illdefined/phq-u/phq-u.kicad_pcb

## KiCad design phq-u.kicad_pcb (2022-02-26)

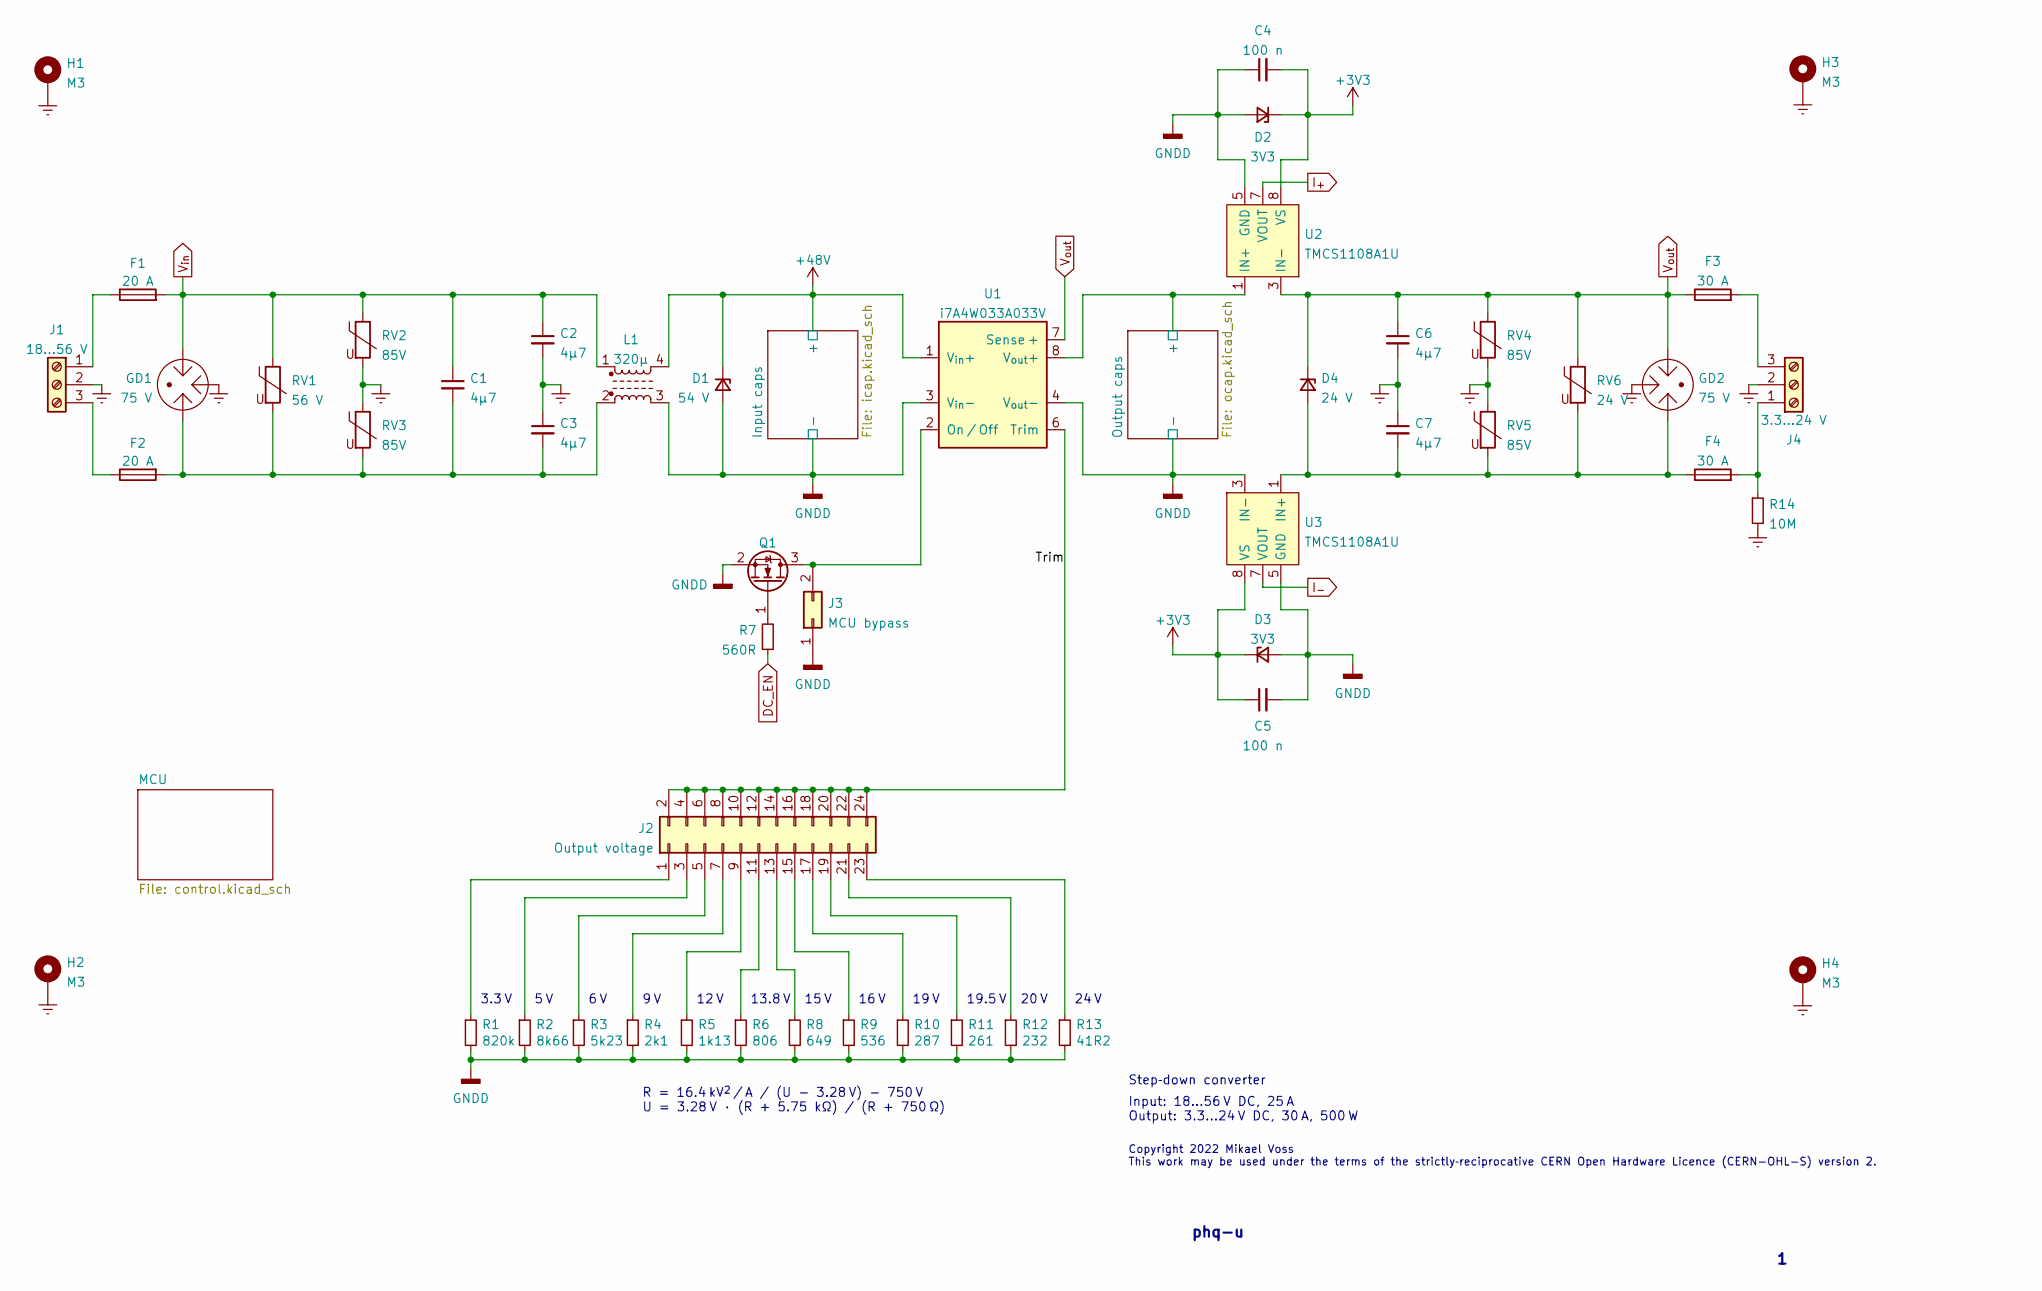
[picture p1: schematic phq-u.kicad_sch]

Parts:
C1, C2, C3, C6, C7: 4µ7; C_1210_3225Metric; Part Number 12101C475K4T2A
C4, C5: 100 n; C_0402_1005Metric
D1: 54 V; D_SMB; Part Number 1.5SMBJ54A-H
D2, D3: 3V3; D_0402_1005Metric; Part Number DF2S5M4CT
D4: 24 V; D_SMA; Part Number SMA6F24A
F1, F2: 20 A; Fuse_2410_20A; Part Number CB61F30A
F3, F4: 30 A; Fuse_2410_20A; Part Number CB61F30A
GD1, GD2: 75 V; 2036-NN-SM; Part Number 2036-07-SM
H1, H2, H3, H4: M3; MountingHole_3.2mm_M3_Pad_Via
J1: 18…56 V; Phoenix_1987737
J2: Output voltage; PinHeader_2x12_P2.00mm_Vertical
J3: MCU bypass; PinHeader_2x01_P2.00mm_Vertical
J4: 3.3…24 V; Phoenix_1987737
L1: 320µ; CMX1211Z321B-10
Q1: NX138AKR; SOT-23; Part Number NX138AKR
R1: 820k; R_0603_1608Metric
R2: 8k66; R_0603_1608Metric
R3: 5k23; R_0603_1608Metric
R4: 2k1; R_0603_1608Metric
R5: 1k13; R_0603_1608Metric
R6: 806; R_0603_1608Metric
R7: 560R; R_0402_1005Metric
R8: 649; R_0603_1608Metric
R9: 536; R_0603_1608Metric
R10: 287; R_0603_1608Metric
R11: 261; R_0603_1608Metric
R12: 232; R_0603_1608Metric
R13: 41R2; R_0603_1608Metric
R14: 10M; R_0603_1608Metric
RV1: 56 V; C_2220_5650Metric; Part Number B72540E0400K062
RV2, RV3, RV4, RV5: 85V; C_1206_3216Metric; Part Number ZV60K1206121NIR1
RV6: 24 V; C_1210_3225Metric; Part Number B72530T6170K062
U1: i7A4W033A033V; i7A4W-0C1; Part Number i7A4W033A033V-0C1
U2, U3: TMCS1108A1U; SOIC-8_3.9x4.9mm_P1.27mm

Connections:
+3V3: C4.2, C5.1, D2.1 (K), D3.1 (K), U2.8 (VS), U3.8 (VS); also elsewhere on the board
+48V: D1.1 (K), L1.4, U1.1 (V_{in}+); also elsewhere on the board
/Output caps/+: U1.8 (V_{out}+), U2.1 (IN+), U2.2 (IN+); also elsewhere on the board
/Trim: J2.2, J2.4, J2.6, J2.8, J2.10, J2.12, J2.14, J2.16, J2.18, J2.20, J2.22, J2.24, U1.6 (Trim)
DC_EN: R7.1; also elsewhere on the board
Earth: C2.2, C3.1, C6.2, C7.1, GD1.2, GD2.2, H1.1, H2.1, H3.1, H4.1, J1.2, J4.2, R14.2, RV2.2, RV3.1, RV4.2, RV5.1
GND: C4.1, C5.2, D1.2 (A), D2.2 (A), D3.2 (A), J3.1, L1.3, Q1.2 (S), R1.2, R2.2, R3.2, R4.2, R5.2, R6.2, R8.2, R9.2, R10.2, R11.2, R12.2, R13.2, U1.3 (V_{in}-), U1.4 (V_{out}-), U2.5 (GND), U2.6 (NC), U3.3 (IN-), U3.4 (IN-), U3.5 (GND), U3.6 (NC); also elsewhere on the board
I_{+}: U2.7 (VOUT); also elsewhere on the board
I_{-}: U3.7 (VOUT); also elsewhere on the board
unnamed: C1.2, C3.2, F2.2, GD1.3, L1.2, RV1.2, RV3.2
unnamed: C7.2, D4.2 (A), F4.1, GD2.1, RV5.2, RV6.2, U3.1 (IN+), U3.2 (IN+)
unnamed: F1.1, J1.1
unnamed: F2.1, J1.3
unnamed: F3.2, J4.3
unnamed: F4.2, J4.1, R14.1
unnamed: J2.1, R1.1
unnamed: J2.3, R2.1
unnamed: J2.5, R3.1
unnamed: J2.7, R4.1
unnamed: J2.9, R5.1
unnamed: J2.11, R6.1
unnamed: J2.13, R8.1
unnamed: J2.15, R9.1
unnamed: J2.17, R10.1
unnamed: J2.19, R11.1
unnamed: J2.21, R12.1
unnamed: J2.23, R13.1
unnamed: J3.2, Q1.3 (D), U1.2 (On / Off)
unnamed: Q1.1 (G), R7.2
V_{in}: C1.1, C2.1, F1.2, GD1.1, L1.1, RV1.1, RV2.1; also elsewhere on the board
V_{out}: C6.1, D4.1 (K), F3.1, GD2.3, RV4.1, RV6.1, U1.7 (Sense +), U2.3 (IN-), U2.4 (IN-); also elsewhere on the board

Notes on the sheet:
12 V
16 V
phq-u
R = 16.4 kV^{2} / A / (U - 3.28 V) - 750 V U = 3.28 V · (R + 5.75 kΩ) / (R + 750 Ω)
15 V
24 V
13.8 V
9 V
Copyright 2022 Mikael Voss This work may be used under the terms of the strictly‐reciprocative CERN Open Hardware Licence (CERN-OHL-S) version 2.
Input: 18…56 V DC, 25 A Output: 3.3…24 V DC, 30 A, 500 W
19.5 V
5 V
19 V
Step‐down converter
6 V
20 V
3.3 V

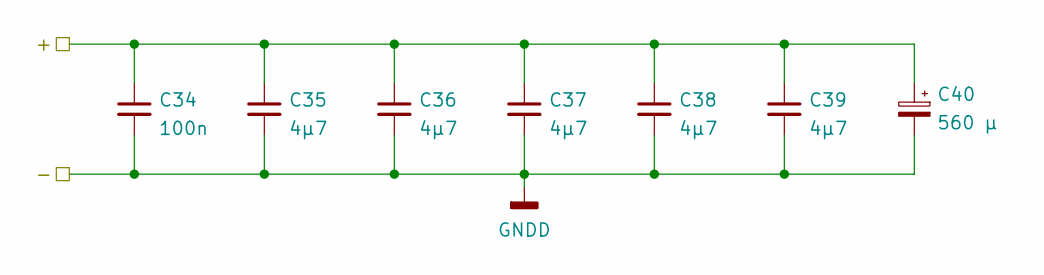
[picture p2: schematic ocap.kicad_sch]

Parts:
C34: 100n; C_0402_1005Metric; Part Number GRM155R71H104KE14D
C35, C36, C37, C38, C39: 4µ7; C_1206_3216Metric; Part Number 12065C475KAT2A
C40: 560 µ; CP_Radial_D10.0mm_P5.00mm; Part Number UHV1V561MPD

Connections:
/Output caps/+: C34.1, C35.1, C36.1, C37.1, C38.1, C39.1, C40.1; also elsewhere on the board
GND: C34.2, C35.2, C36.2, C37.2, C38.2, C39.2, C40.2; also elsewhere on the board

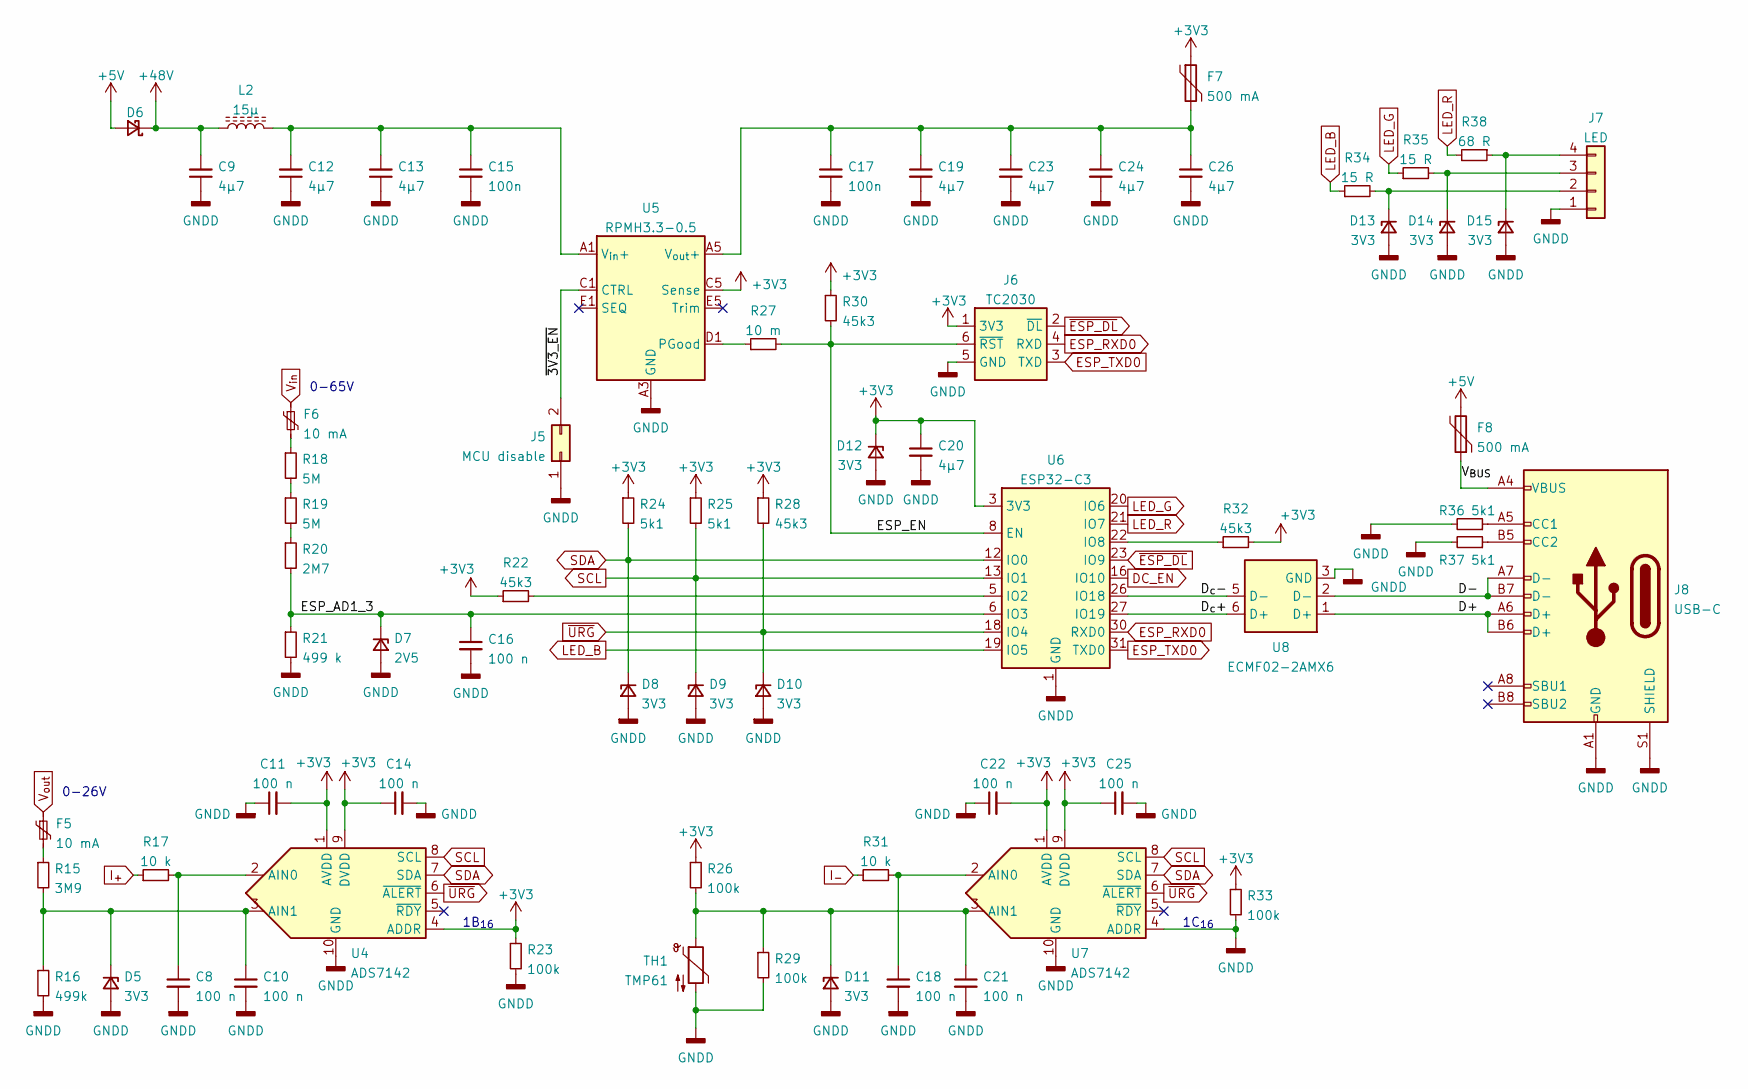
[picture p3: schematic control.kicad_sch]

Parts:
C8, C10, C11, C14, C18, C21, C22, C25: 100 n; C_0402_1005Metric; Part Number JMK105B7104KV-F
C9, C12, C13: 4µ7; C_1206_3216Metric; Part Number GRJ31CZ72A475KE01L
C15: 100n; C_0603_1608Metric; Part Number HMK107B7104KA
C16: 100 n; C_0402_1005Metric
C17: 100n; C_0402_1005Metric; Part Number GRM155R71E104KE14J
C19, C20, C23, C24, C26: 4µ7; C_0805_2012Metric; Part Number GRM21BR71A475KE51L
D5, D8, D9, D10, D11, D12, D13, D14, D15: 3V3; D_0402_1005Metric; Part Number DF2S5M4CT
D6: Schottky diode; D_SMF; Part Number SS1FN6
D7: 2V5; D_0402_1005Metric; Part Number UCLAMP2501T.TCT
F5, F6: 10 mA; Fuse_0603_1608Metric; Part Number 0ZCM0001FF2G
F7, F8: 500 mA; Fuse_0603_1608Metric; Part Number MF-FSML050/8-2
J5: MCU disable; PinHeader_2x01_P2.00mm_Vertical
J6: TC2030
J7: LED; PinHeader_1x04_P2.00mm_Vertical
J8: USB-C; USB4120
L2: 15µ; WE-LQS_4018; Part Number 74438356150
R15: 3M9; R_1206_3216Metric
R16: 499k; R_0805_2012Metric
R17, R31: 10 k; R_0402_1005Metric
R18, R19: 5M; R_1206_3216Metric
R20: 2M7; R_1206_3216Metric
R21: 499 k; R_0805_2012Metric
R22, R28, R30, R32: 45k3; R_0402_1005Metric
R23, R26, R29, R33: 100k; R_0402_1005Metric
R24, R25, R36, R37: 5k1; R_0402_1005Metric
R27: 10 m; R_0805_2012Metric
R34, R35: 15 R; R_0402_1005Metric
R38: 68 R; R_0402_1005Metric
TH1: TMP61; R_0402_1005Metric
U4, U7: ADS7142; Texas_R-PUQFN-N10
U5: RPMH3.3-0.5; Converter_DCDC_RECOM_RPMx.x-x.0
U6: ESP32-C3; ESP32-C3-MINI-1U
U8: ECMF02-2AMX6; ST_UQFN-6L_1.5x1.7mm_Pitch0.5mm

Connections:
+3V3: C11.2, C14.1, C20.1, C22.2, C25.1, D12.1 (K), F7.1, J6.1 (3V3), R22.1, R23.1, R24.1, R25.1, R26.1, R28.1, R30.1, R32.2, R33.1, U4.1 (AVDD), U4.4 (ADDR), U4.9 (DVDD), U5.C5 (Sense), U6.3 (3V3), U7.1 (AVDD), U7.9 (DVDD); also elsewhere on the board
+5V: D6.2 (A), F8.2
+48V: C9.2, D6.1 (K), L2.1; also elsewhere on the board
/MCU/D+: J8.A6 (D+), J8.B6 (D+), U8.1 (D+)
/MCU/D-: J8.A7 (D-), J8.B7 (D-), U8.2 (D-)
/MCU/D_{c}+: U6.27 (IO19), U8.6 (D+)
/MCU/D_{c}-: U6.26 (IO18), U8.5 (D-)
/MCU/ESP_AD1_3: C16.1, D7.1 (K), R20.2, R21.1, U6.6 (IO3)
/MCU/ESP_EN: J6.6 (~RST), R27.2, R30.2, U6.8 (EN)
/MCU/V_{BUS}: F8.1, J8.A4 (VBUS), J8.A9 (VBUS), J8.B4 (VBUS), J8.B9 (VBUS)
/MCU/~3V3_EN: J5.2, U5.C1 (CTRL)
DC_EN: U6.16 (IO10); also elsewhere on the board
ESP_RXD0: J6.4 (RXD), U6.30 (RXD0)
ESP_TXD0: J6.3 (TXD), U6.31 (TXD0)
GND: C8.2, C9.1, C10.2, C11.1, C12.1, C13.1, C14.2, C15.2, C16.2, C17.2, C18.2, C19.2, C20.2, C21.2, C22.1, C23.2, C24.2, C25.2, C26.2, D5.2 (A), D7.2 (A), D8.2 (A), D9.2 (A), D10.2 (A), D11.2 (A), D12.2 (A), D13.2 (A), D14.2 (A), D15.2 (A), J5.1, J6.5 (GND), J7.1, J8.A1 (GND), J8.A12 (GND), J8.B1 (GND), J8.B12 (GND), J8.S1 (SHIELD), J8.S2 (SHIELD), J8.S3 (SHIELD), J8.S4 (SHIELD), R16.2, R21.2, R23.2, R29.2, R33.2, R36.2, R37.2, TH1.2, U4.10 (GND), U5.A3 (GND), U5.A4 (GND), U5.B1 (GND), U5.B2 (GND), U5.B3 (GND), U5.B4 (GND), U5.C2 (GND), U5.C3 (GND), U5.C4 (GND), U5.D2 (GND), U5.D3 (GND), U5.D4 (GND), U5.D5 (GND), U5.E3 (GND), U5.E4 (GND), U6.1 (GND), U6.2 (GND), U6.11 (GND), U6.14 (GND), U6.36 (GND), U6.37 (GND), U6.38 (GND), U6.39 (GND), U6.40 (GND), U6.41 (GND), U6.42 (GND), U6.43 (GND), U6.44 (GND), U6.45 (GND), U6.46 (GND), U6.47 (GND), U6.48 (GND), U6.49_1 (GND), U6.49_2 (GND), U6.49_3 (GND), U6.49_4 (GND), U6.49_5 (GND), U6.49_6 (GND), U6.49_7 (GND), U6.49_8 (GND), U6.49_9 (GND), U6.50 (GND), U6.51 (GND), U6.52 (GND), U6.53 (GND), U7.4 (ADDR), U7.10 (GND), U8.3 (GND), U8.4 (NC); also elsewhere on the board
I_{+}: R17.1; also elsewhere on the board
I_{-}: R31.1; also elsewhere on the board
LED_B: R34.1, U6.19 (IO5)
LED_G: R35.1, U6.20 (IO6)
LED_R: R38.2, U6.21 (IO7)
unnamed: C8.1, R17.2, U4.2 (AIN0)
unnamed: C10.1, D5.1 (K), R15.2, R16.1, U4.3 (AIN1)
unnamed: C12.2, C13.2, C15.1, L2.2, U5.A1 (V_{in}+), U5.A2 (V_{in}+)
unnamed: C17.1, C19.1, C23.1, C24.1, C26.1, F7.2, U5.A5 (V_{out}+), U5.B5 (V_{out}+)
unnamed: C18.1, R31.2, U7.2 (AIN0)
unnamed: C21.1, D11.1 (K), R26.2, R29.1, TH1.1, U7.3 (AIN1)
unnamed: D13.1 (K), J7.2, R34.2
unnamed: D14.1 (K), J7.3, R35.2
unnamed: D15.1 (K), J7.4, R38.1
unnamed: F5.2, R15.1
unnamed: F6.2, R18.1
unnamed: J8.A5 (CC1), R36.1
unnamed: J8.B5 (CC2), R37.1
unnamed: R18.2, R19.1
unnamed: R19.2, R20.1
unnamed: R22.2, U6.5 (IO2)
unnamed: R27.1, U5.D1 (PGood)
unnamed: R32.1, U6.22 (IO8)
SCL: D9.1 (K), R25.2, U4.8 (SCL), U6.13 (IO1), U7.8 (SCL)
SDA: D8.1 (K), R24.2, U4.7 (SDA), U6.12 (IO0), U7.7 (SDA)
V_{in}: F6.1; also elsewhere on the board
V_{out}: F5.1; also elsewhere on the board
~ESP_DL: J6.2 (~DL), U6.23 (IO9)
~URG: D10.1 (K), R28.2, U4.6 (~ALERT), U6.18 (IO4), U7.6 (~ALERT)

Notes on the sheet:
1C_{16}
0-26V
0-65V
1B_{16}

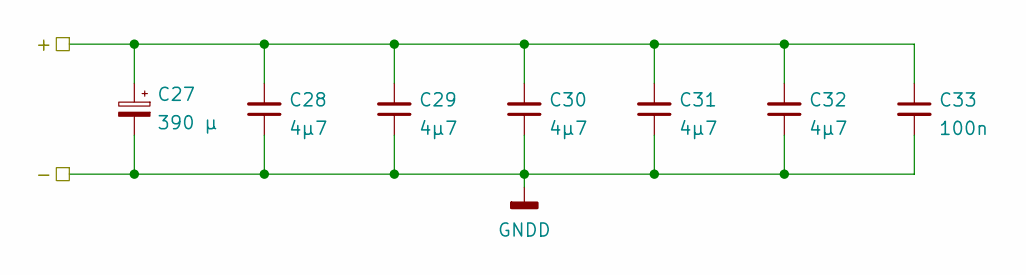
[picture p4: schematic icap.kicad_sch]

Parts:
C27: 390 µ; CP_Radial_D12.5mm_P5.00mm; Part Number UHW1J391MHD6
C28, C29, C30, C31, C32: 4µ7; C_1206_3216Metric; Part Number GRJ31CZ72A475KE01L
C33: 100n; C_0603_1608Metric; Part Number HMK107B7104KA

Connections:
+48V: C27.1, C28.2, C29.2, C30.2, C31.2, C32.2, C33.1; also elsewhere on the board
GND: C27.2, C28.1, C29.1, C30.1, C31.1, C32.1, C33.2; also elsewhere on the board

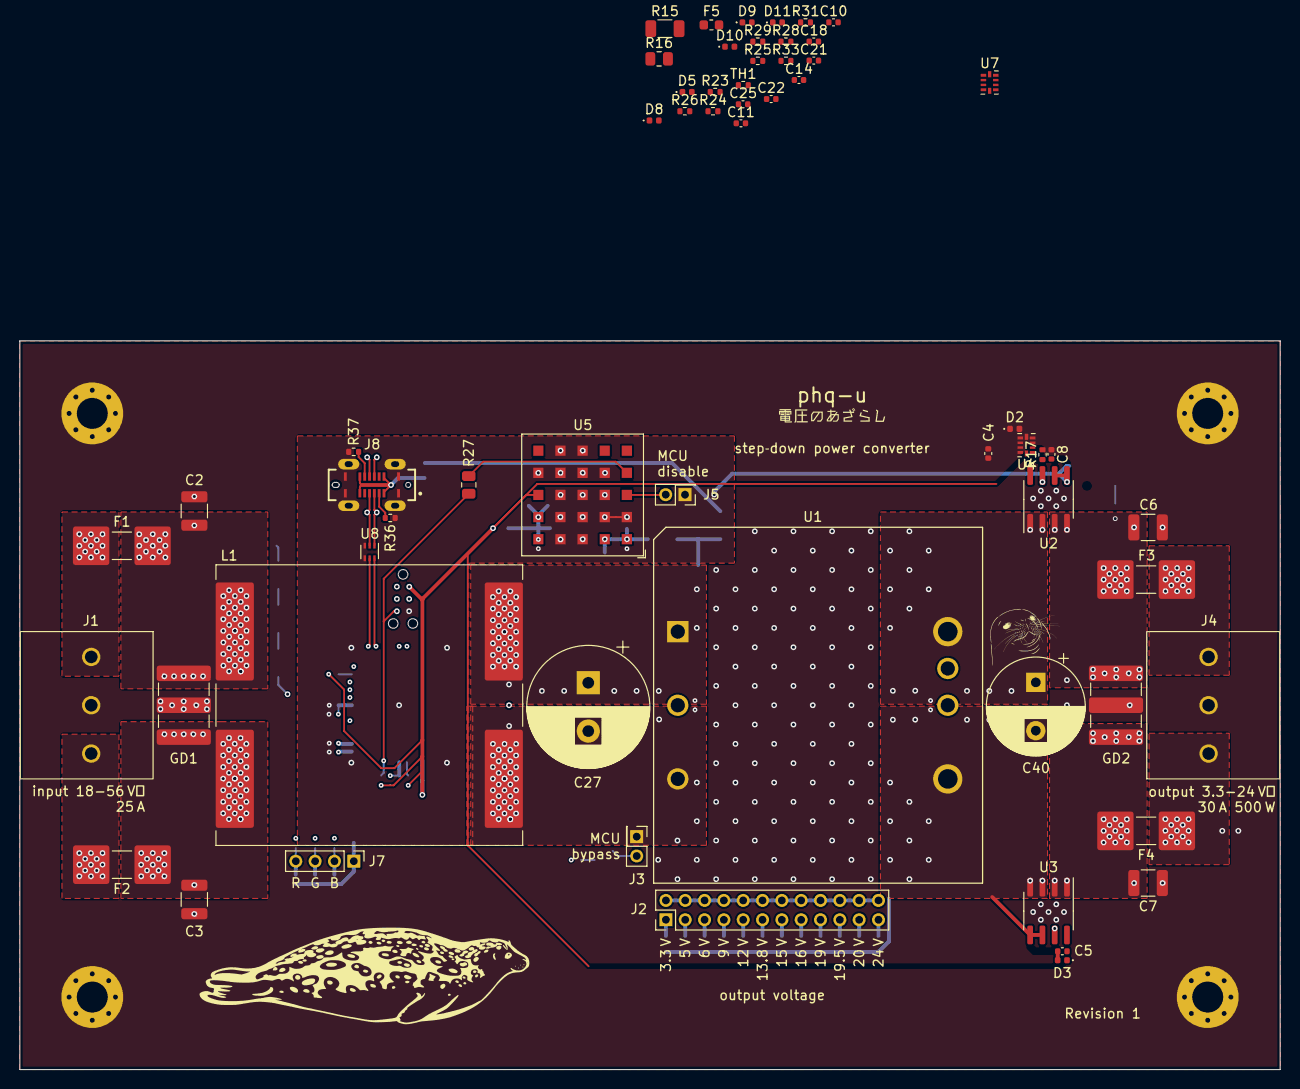
[picture p5: board phq-u.kicad_pcb from above]

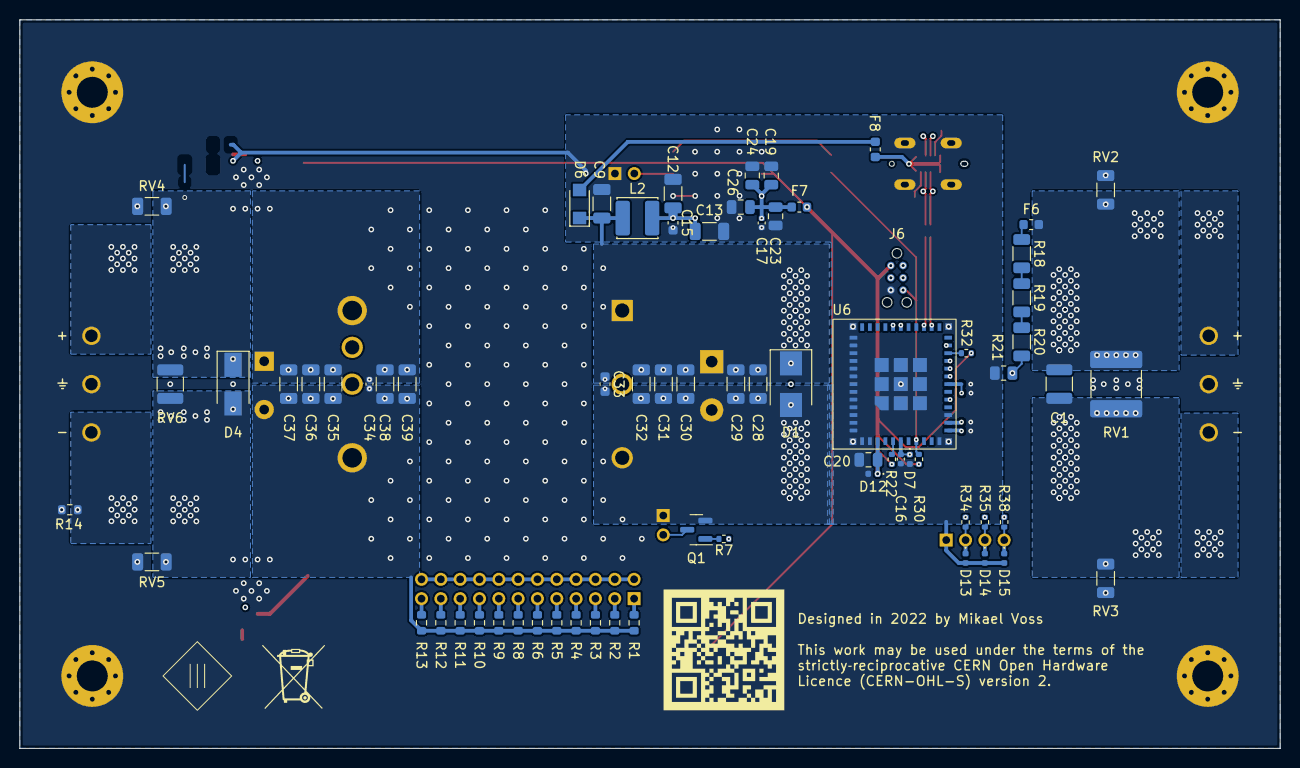
[picture p6: board phq-u.kicad_pcb from below]

Board: 4 copper layers, 130.4 x 75.4 mm, 133 parts (69 on the bottom side), 67 nets.
