illdefined/phq-u/phoqueu.kicad_pcb

## KiCad design phoqueu.kicad_pcb (2022-02-01)

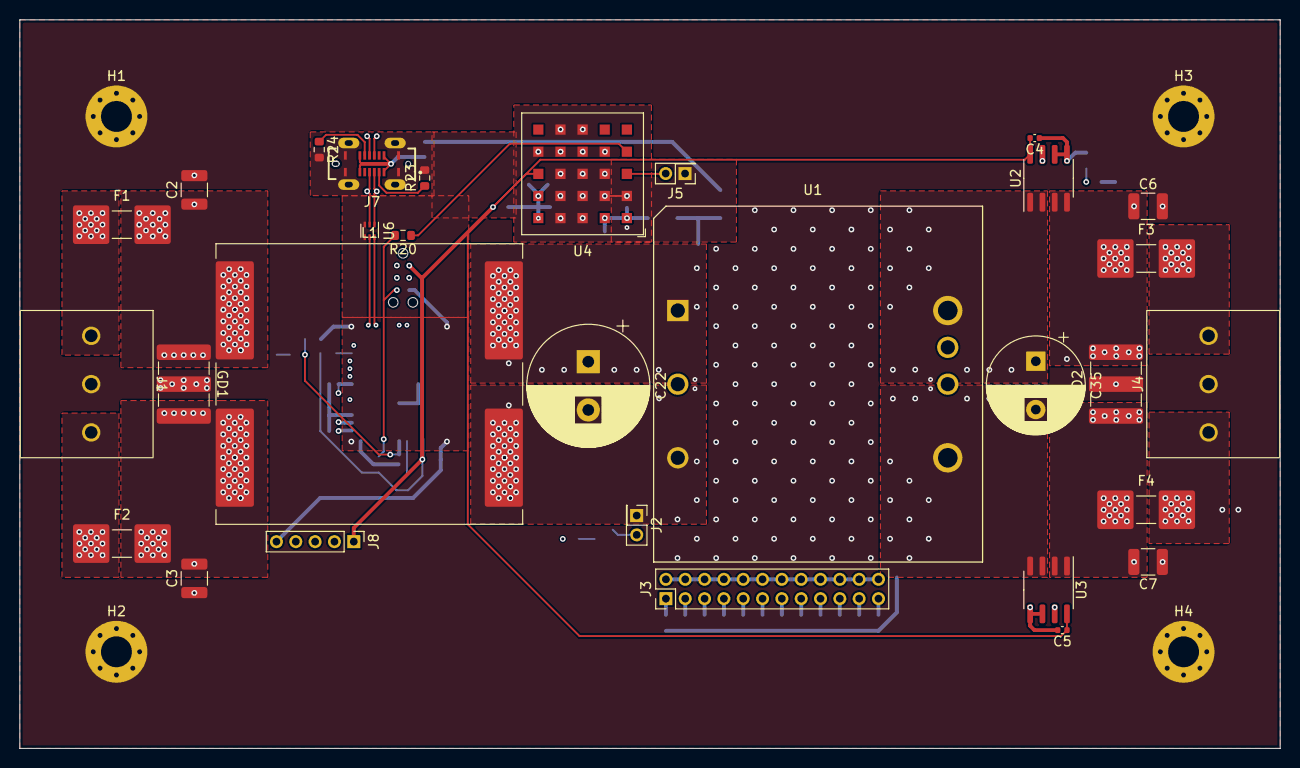
[picture p7: board phoqueu.kicad_pcb from above]

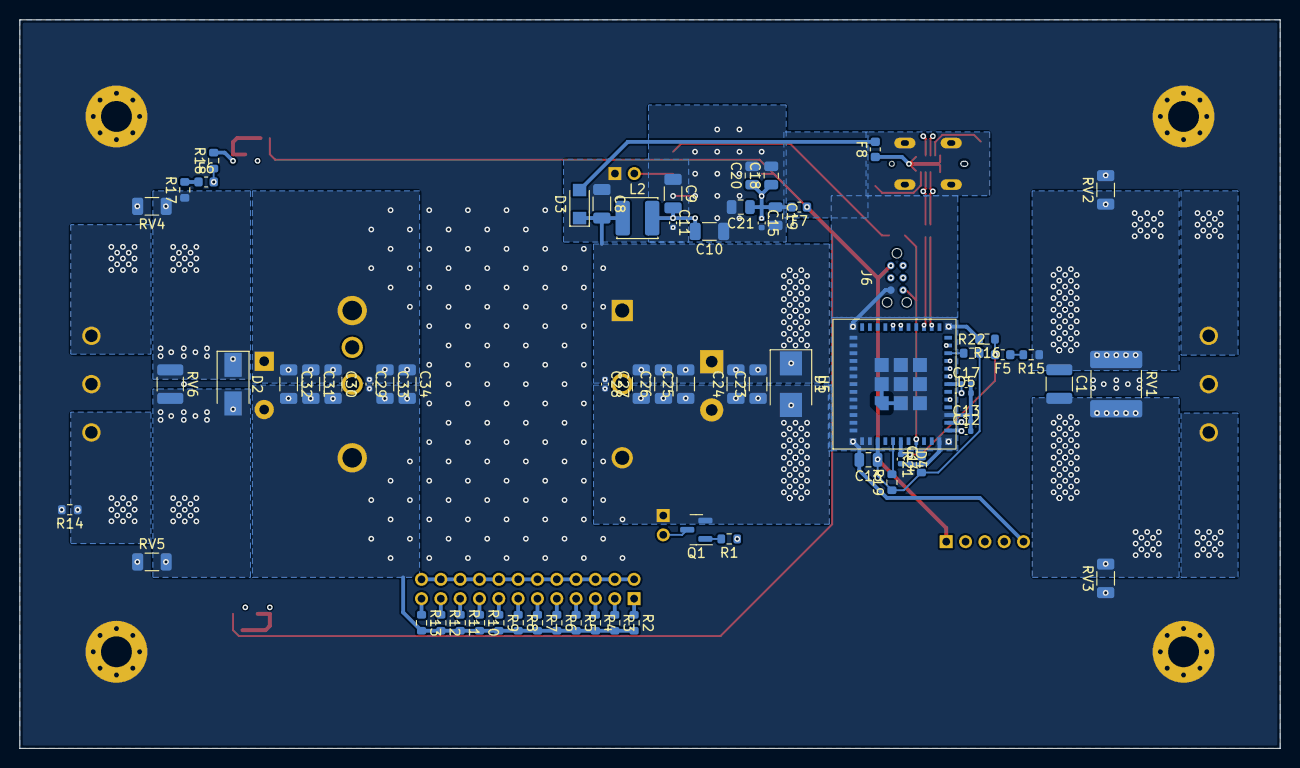
[picture p8: board phoqueu.kicad_pcb from below]

Board: 4 copper layers, 130.4 x 75.4 mm, 101 parts (67 on the bottom side), 56 nets.

Parts:
C1, C2, C3, C6, C7: 4µ7; C_1210_3225Metric
C4, C5, C12, C13, C14, C17: 100 n; C_0402_1005Metric
C8, C9, C10, C23, C24, C25, C26, C27, C30, C31, C32, C33, C34: 4µ7; C_1206_3216Metric
C11, C15, C28, C29: 100n; C_0402_1005Metric
C16, C18, C19, C20, C21: 4µ7; C_0805_2012Metric
C22: 390 µ; CP_Radial_D12.5mm_P5.00mm
C35: 560 µ; CP_Radial_D10.0mm_P5.00mm
D1: 54 V; D_SMB
D2: 24 V; D_SMA
D3: Schottky diode; D_SMF
D4, D5: 2V5; D_0402_1005Metric
F1, F2, F3, F4: 30 A; Fuse_2410_20A
F5, F6: 10 mA; Fuse_0603_1608Metric
F7, F8: 500 mA; Fuse_0603_1608Metric
GD1, GD2: 75 V; 2036-NN-SM
H1, H2, H3, H4: M3; MountingHole_3.2mm_M3_Pad_Via
J1: 18…56 V; Phoenix_1987737
J2: MCU bypass; PinHeader_2x01_P2.00mm_Vertical
J3: Voltage select; PinHeader_2x12_P2.00mm_Vertical
J4: 3.3…24 V; Phoenix_1987737
J5: MCU disable; PinHeader_2x01_P2.00mm_Vertical
J6: TC2030
J7: USB-C; USB4120
J8: I/O; PinHeader_1x05_P2.00mm_Vertical
L1: 320µ; CMX1211Z321B-10
L2: 15µ; WE-LQS_4018
Q1: NX138AK; SOT-23
R1: 560R; R_0603_1608Metric
R2: 820k; R_0603_1608Metric
R3: 8k76; R_0603_1608Metric
R4: 5k23; R_0603_1608Metric
R5: 2k1; R_0603_1608Metric
R6: 1k13; R_0603_1608Metric
R7: 806; R_0603_1608Metric
R8: 649; R_0603_1608Metric
R9: 536; R_0603_1608Metric
R10: 294; R_0603_1608Metric
R11: 261; R_0603_1608Metric
R12: 232; R_0603_1608Metric
R13: 41R2; R_0603_1608Metric
R14: 10M; R_0603_1608Metric
R15: 25M; R_0603_1608Metric
R16: 1M; R_0603_1608Metric
R17: 4M7; R_0603_1608Metric
R18: 500k; R_0603_1608Metric
R19, R21, R22: 45k3; R_0603_1608Metric
R20: 0; R_0603_1608Metric
R23, R24: 5k1; R_0603_1608Metric
RV1: 56 V; C_2220_5650Metric
RV2, RV3, RV4, RV5: 85V; C_1206_3216Metric
RV6: 24 V; C_1210_3225Metric
U1: i7A4W033A033V; i7A4W-0C1
U2, U3: TMCS1108A1U; SOIC-8_3.9x4.9mm_P1.27mm
U4: RPMH3.3-0.5; Converter_DCDC_RECOM_RPMx.x-x.0
U5: ESP32-C3; ESP32-C3-MINI-1U
U6: ECMF02-2AMX6; ST_UQFN-6L_1.5x1.7mm_Pitch0.5mm

Connections:
+3V3: C4.2, C5.1, C16.1, F7.1, J6.1 (3V3), J8.1, R19.1, R21.1, R22.2, U2.8 (VS), U3.8 (VS), U4.C5 (Sense), U5.3 (3V3)
+5V: D3.2 (A), F8.2
+48V: C8.2, C22.1, C23.2, C24.2, C25.2, C26.2, C27.2, C28.1, D1.1 (K), D3.1 (K), L1.4, L2.1, U1.1 (V_{in}+)
/MCU/D+: J7.A6 (D+), J7.B6 (D+), U6.1 (D+)
/MCU/D-: J7.A7 (D-), J7.B7 (D-), U6.2 (D-)
/MCU/D_{c}+: U5.27 (IO19), U6.6 (D+)
/MCU/D_{c}-: U5.26 (IO18), U6.5 (D-)
/MCU/ESP_AD1_3: C14.1, D4.1 (K), F5.2, R16.1, U5.6 (IO3)
/MCU/ESP_AD1_4: C17.1, D5.1 (K), F6.2, R18.1, U5.18 (IO4)
/MCU/ESP_EN: J6.6 (~RST), R20.2, R21.2, U5.8 (EN)
/MCU/V_{BUS}: F8.1, J7.A4 (VBUS), J7.A9 (VBUS), J7.B4 (VBUS), J7.B9 (VBUS)
/MCU/~3V3_EN: J5.2, U4.C1 (CTRL)
/Output caps/in+: C29.1, C30.1, C31.1, C32.1, C33.1, C34.1, C35.1, U1.8 (V_{out}+), U2.1 (IN+), U2.2 (IN+)
/Trim: J3.2, J3.4, J3.6, J3.8, J3.10, J3.12, J3.14, J3.16, J3.18, J3.20, J3.22, J3.24, U1.6 (Trim)
/V_{inr}+: F1.1, J1.1
/V_{inr}-: F2.1, J1.3
/V_{out}+: F3.2, J4.3
/V_{out}-: F4.2, J4.1, R14.1
ESP_AD1_0: C12.1, U3.7 (VOUT), U5.12 (IO0)
ESP_AD1_1: C13.1, U2.7 (VOUT), U5.13 (IO1)
ESP_IO5: J8.2, U5.19 (IO5)
ESP_IO6: J8.3, U5.20 (IO6)
ESP_IO7: J8.4, U5.21 (IO7)
ESP_IO9: J6.2 (~DL), U5.23 (IO9)
ESP_IO10: R1.1, U5.16 (IO10)
ESP_RXD0: J6.4 (RXD), U5.30 (RXD0)
ESP_TXD0: J6.3 (TXD), U5.31 (TXD0)
Earth: C2.2, C3.1, C6.2, C7.1, GD1.2, GD2.2, H1.1, H2.1, H3.1, H4.1, J1.2, J4.2, R14.2, RV2.2, RV3.1, RV4.2, RV5.1
GND: C4.1, C5.2, C8.1, C9.1, C10.1, C11.2, C12.2, C13.2, C14.2, C15.2, C16.2, C17.2, C18.2, C19.2, C20.2, C21.2, C22.2, C23.1, C24.1, C25.1, C26.1, C27.1, C28.2, C29.2, C30.2, C31.2, C32.2, C33.2, C34.2, C35.2, D1.2 (A), D4.2 (A), D5.2 (A), J2.1, J5.1, J6.5 (GND), J7.A1 (GND), J7.A12 (GND), J7.B1 (GND), J7.B12 (GND), J7.S1 (SHIELD), J7.S2, J7.S3, J7.S4, J8.5, L1.3, Q1.2 (S), R2.2, R3.2, R4.2, R5.2, R6.2, R7.2, R8.2, R9.2, R10.2, R11.2, R12.2, R13.2, R16.2, R18.2, R23.2, R24.2, U1.3 (V_{in}-), U1.4 (V_{out}-), U2.5 (GND), U2.6 (NC), U3.3 (IN-), U3.4 (IN-), U3.5 (GND), U3.6 (NC), U4.A3 (GND), U4.A4 (GND), U4.B1 (GND), U4.B2 (GND), U4.B3 (GND), U4.B4 (GND), U4.C2 (GND), U4.C3 (GND), U4.C4 (GND), U4.D2 (GND), U4.D3 (GND), U4.D4 (GND), U4.D5 (GND), U4.E3 (GND), U4.E4 (GND), U5.1 (GND), U5.2 (GND), U5.11 (GND), U5.14 (GND), U5.36 (GND), U5.37 (GND), U5.38 (GND), U5.39 (GND), U5.40 (GND), U5.41 (GND), U5.42 (GND), U5.43 (GND), U5.44 (GND), U5.45 (GND), U5.46 (GND), U5.47 (GND), U5.48 (GND), U5.49_1 (GND), U5.49_2 (GND), U5.49_3 (GND), U5.49_4 (GND), U5.49_5 (GND), U5.49_6 (GND), U5.49_7 (GND), U5.49_8 (GND), U5.49_9 (GND), U5.50 (GND), U5.51 (GND), U5.52 (GND), U5.53 (GND), U6.3 (GND), U6.4 (NC)
unnamed: C1.2, C3.2, F2.2, GD1.3, L1.2, RV1.2, RV3.2
unnamed: C7.2, D2.2 (A), F4.1, GD2.1, RV5.2, RV6.2, U3.1 (IN+), U3.2 (IN+)
unnamed: C9.2, C10.2, C11.1, L2.2, U4.A1 (V_{in}+), U4.A2 (V_{in}+)
unnamed: C15.1, C18.1, C19.1, C20.1, C21.1, F7.2, U4.A5 (V_{out}+), U4.B5 (V_{out}+)
unnamed: F5.1, R15.2
unnamed: F6.1, R17.2
unnamed: J2.2, Q1.3 (D), U1.2 (On / Off)
unnamed: J3.3, R3.1
unnamed: J3.17, R10.1
unnamed: J3.19, R11.1
unnamed: J3.21, R12.1
unnamed: J3.23, R13.1
unnamed: J7.A5 (CC1), R23.1
unnamed: J7.B5 (CC2), R24.1
unnamed: Q1.1 (G), R1.2
unnamed: J3.1, R2.1
unnamed: J3.5, R4.1
unnamed: J3.7, R5.1
unnamed: J3.9, R6.1
unnamed: J3.11, R7.1
unnamed: J3.13, R8.1
unnamed: J3.15, R9.1
unnamed: R19.2, U5.5 (IO2)
unnamed: R20.1, U4.D1 (PGood)
unnamed: R22.1, U5.22 (IO8)
V_{in}: C1.1, C2.1, F1.2, GD1.1, L1.1, R15.1, RV1.1, RV2.1
V_{out}: C6.1, D2.1 (K), F3.1, GD2.3, R17.1, RV4.1, RV6.1, U1.7 (Sense +), U2.3 (IN-), U2.4 (IN-)
