illdefined/phq-u/phoque-u.kicad_pcb

## KiCad design phoque-u.kicad_pcb (2022-01-10)

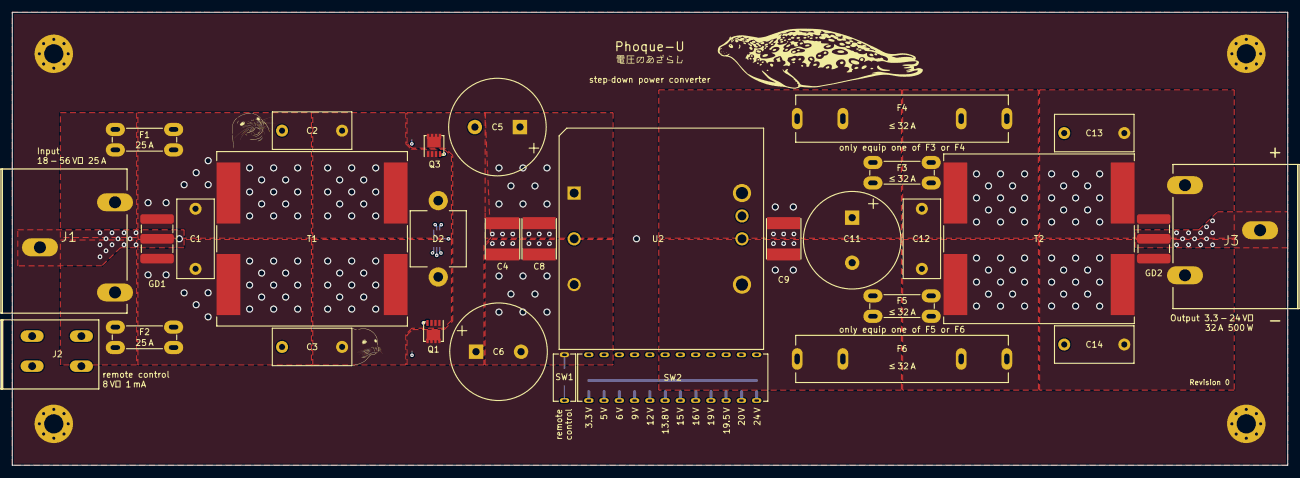
[picture p9: board phoque-u.kicad_pcb from above]

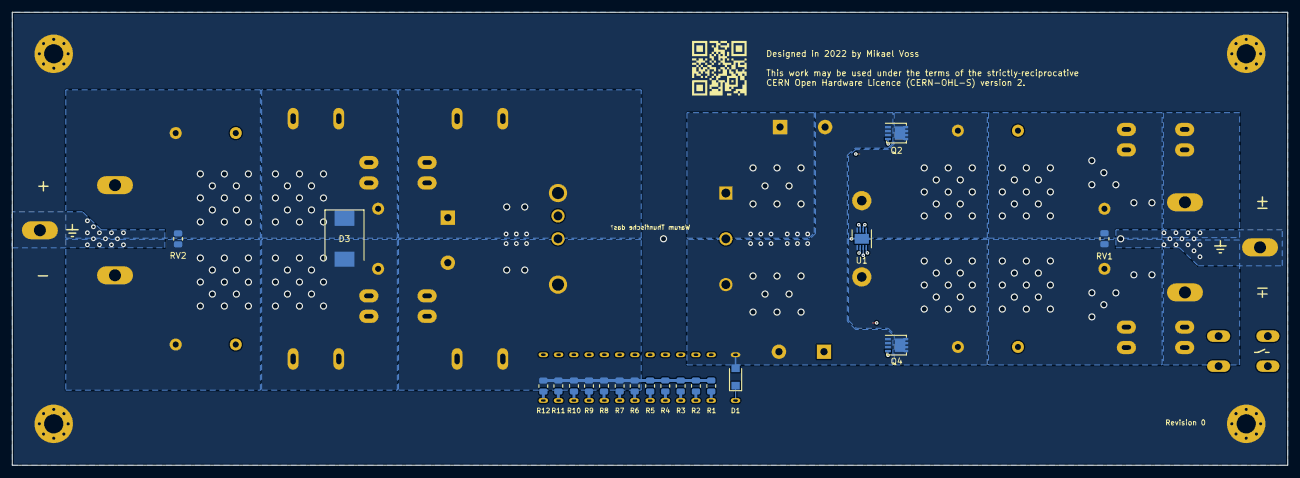
[picture p10: board phoque-u.kicad_pcb from below]

Board: 4 copper layers, 212.3 x 75.4 mm, 54 parts (19 on the bottom side), 33 nets.

Parts:
C1, C2, C3, C12, C13, C14: 4n7; C_Disc_D13mm_W6.0mm_P10.00mm
C4, C8, C9: 22 µ; KRM55WR71J226MH01
C5, C6, C11: 470 µ; CP_Radial_D16.0mm_P7.50mm
D1: 8 V; D_SMF
D2: 56 V; D_BZW50-56B_P12.70mm_Horizontal
D3: 24 V; D_SMC
F1, F2: 25 A; 3557
F3, F5: ≤ 32 A; 3557
F4, F6: ≤ 32 A; 8040
GD1, GD2: 75 V; 2036-NN-SM
H1, H2, H3, H4: M3; MountingHole_3.2mm_M3_Pad_Via
J1: 18…56 V; 2606-1103
J2: On / Off; 2604-1102
J3: 3.3…24 V; 2606-1103
Q1, Q2, Q3, Q4: SiR120DP; Vishay_PowerPAK_1212-8_Single
R1: 820k; R_0805_2012Metric
R2: 8k76; R_0805_2012Metric
R3: 5k23; R_0805_2012Metric
R4: 2k1; R_0805_2012Metric
R5: 1k13; R_0805_2012Metric
R6: 806; R_0805_2012Metric
R7: 649; R_0805_2012Metric
R8: 536; R_0805_2012Metric
R9: 294; R_0805_2012Metric
R10: 261; R_0805_2012Metric
R11: 232; R_0805_2012Metric
R12: 41R2; R_0805_2012Metric
RV1: 56 V; R_0805_2012Metric
RV2: 24 V; R_0805_2012Metric
SW1: Remote; 418127160901
SW2: Voltage select; 418127160912
T1: 320 µ; CMX1211Z321B-10
T2: 180 µ; CMX1211Z181B-10
U1: LT4320; DFN-8-1EP_3x3mm_P0.5mm_EP1.65x2.38mm
U2: i7A4W033A033V; i7A4W033A033V-0C1

Connections:
/G_{Q1}: Q1.4 (G), U1.2 (TG2)
/G_{Q2}: Q2.4 (G), U1.3 (BG2)
/G_{Q3}: Q3.4 (G), U1.7 (TG1)
/G_{Q4}: Q4.4 (G), U1.4 (BG1)
/On/Off: D1.1 (K), J2.1, SW1.1 (A), U2.2 (On / Off)
/Trim: SW2.13, SW2.14, SW2.15, SW2.16, SW2.17, SW2.18, SW2.19, SW2.20, SW2.21, SW2.22, SW2.23, SW2.24, U2.6 (Trim)
/V_{infilt}±: C2.1, D2.2 (A2), Q2.5 (D), Q3.1 (S), Q3.2 (S), Q3.3 (S), T1.2 (AB), U1.8 (IN1)
/V_{infilt}∓: C3.2, D2.1 (A1), Q1.1 (S), Q1.2 (S), Q1.3 (S), Q4.5 (D), T1.3 (SA), U1.1 (IN2)
/V_{infuse}±: C1.1, F1.2, GD1.1, RV1.1, T1.1 (AA)
/V_{infuse}∓: C1.2, F2.2, GD1.3, RV1.2, T1.4 (SB)
/V_{in}+: C4.1, C5.1, C6.1, C8.1, Q1.5 (D), Q3.5 (D), U1.6 (OUTP), U2.1 (Vin +)
/V_{in}-: C4.2, C5.2, C6.2, C8.2, D1.2 (A), J2.2, Q2.1 (S), Q2.2 (S), Q2.3 (S), Q4.1 (S), Q4.2 (S), Q4.3 (S), SW1.2 (B), U1.5 (OUTN), U1.9 (OUTN), U2.3 (Vin -)
/V_{in}±: F1.1, J1.1
/V_{in}∓: F2.1, J1.3
/V_{outfilt}+: C13.1, GD2.3, J3.3, RV2.1, T2.2 (AB), U2.7 (Sense +)
/V_{outfilt}-: C14.2, GD2.1, J3.1, RV2.2, T2.3 (SA)
/V_{outfuse}+: C12.2, D3.1 (K), F3.2, F4.2, T2.1 (AA)
/V_{outfuse}-: C12.1, D3.2 (A), F5.2, F6.2, T2.4 (SB)
/V_{out}+: C9.1, C11.1, F3.1, F4.1, U2.8 (Vout +)
/V_{out}-: C9.2, C11.2, F5.1, F6.1, R1.2, R2.2, R3.2, R4.2, R5.2, R6.2, R7.2, R8.2, R9.2, R10.2, R11.2, R12.2, U2.4 (Vout -)
GND: C2.2, C3.1, C13.2, C14.1, GD1.2, GD2.2, H1.1, H2.1, H3.1, H4.1, J1.2, J3.2
unnamed: R1.1, SW2.1
unnamed: R2.1, SW2.2
unnamed: R3.1, SW2.3
unnamed: R4.1, SW2.4
unnamed: R5.1, SW2.5
unnamed: R6.1, SW2.6
unnamed: R7.1, SW2.7
unnamed: R8.1, SW2.8
unnamed: R9.1, SW2.9
unnamed: R10.1, SW2.10
unnamed: R11.1, SW2.11
unnamed: R12.1, SW2.12
