illdefined/phq-u/(commit log)

2022-01-04 Initial import
    [phoque-u.kicad_sch]
2022-01-05 Update schematic according to parts availability
    [phoque-u.kicad_sch]
2022-01-05 Specify full part number for DC/DC module
    [phoque-u.kicad_sch]
2022-01-05 Add footprints
    [phoque-u.kicad_sch]
2022-01-05 Replace switches
    [phoque-u.kicad_sch]
2022-01-05 i7A4W033A033V: Remove pins 9 & 10
    [phoque-u.kicad_sch]
2022-01-05 2606-1103: Correct pin numbers
2022-01-05 Remove film capacitors
    [phoque-u.kicad_sch]
2022-01-06 Remove test points
    [phoque-u.kicad_sch]
2022-01-07 Add initial PCB layout
    [phoque-u.kicad_pcb, phoque-u.kicad_sch]
2022-01-07 Optimise paths between rectifier and converter
    [phoque-u.kicad_pcb]
2022-01-08 Add dedicated signal and ground layers
    This reduces the board dimensions considerably.
    [phoque-u.kicad_pcb, phoque-u.kicad_sch]
2022-01-08 Cut board to 212.3 × 75 cm
    [phoque-u.kicad_pcb]
2022-01-08 Correct zone clearances
    [phoque-u.kicad_pcb]
2022-01-08 Centre PCB
    [phoque-u.kicad_pcb]
2022-01-08 Widen board for better fit and add mounting holes
    [phoque-u.kicad_pcb, phoque-u.kicad_sch]
2022-01-08 Customise PCB stackup
    [phoque-u.kicad_pcb]
2022-01-09 Clean up silkscreen
    [phoque-u.kicad_pcb, phoque-u.kicad_sch]
2022-01-09 Reduce zone clearance to 0.2 mm
    Coating will be much more useful.
    [phoque-u.kicad_pcb]
2022-01-09 Clear pads from silkscreen
    [phoque-u.kicad_pcb, phoque-u.kicad_sch]
2022-01-09 Attempt to optimise high‐current paths
    [phoque-u.kicad_pcb]
2022-01-10 Finalise silkscreen
    [phoque-u.kicad_pcb]
2022-01-10 Remove hyphen‐minus from project name
    [phoqueu.kicad_pcb, phoqueu.kicad_sch]
2022-01-10 Correct zone overlap
    [phoqueu.kicad_pcb]
2022-01-10 Add JLC order number to silkscreen
    [phoqueu.kicad_pcb]
2022-01-12 Add remote control circuit details to silkscreen
    [phoqueu.kicad_pcb]
2022-01-24 Add external symbol and footprint library
2022-01-24 Revise schematic
    - Remove remote on/off connector,
    - remove extra fuses,
    - adjust overvoltage protection values,
    - replace switches with pin headers,
    - replace input and output power connectors,
    - add microcontroller for supervision,
    - add hall‐effect current sensors,
    - adjust electrolytic capacitors,
    - remove output common‐mode choke,
    - adjust filter capacitors,
    - remove rectifier circuit,
    - add varistors to limit earth potentials.
    [control.kicad_sch, phoqueu.kicad_sch]
2022-01-24 Add phq_Symbol footprint library
2022-01-24 Complete footprint assignments
    [control.kicad_sch, phoqueu.kicad_sch]
2022-02-01 Complete placement and routeing
    [control.kicad_sch, icap.kicad_sch, ocap.kicad_sch, phoqueu.kicad_pcb, phoqueu.kicad_sch]
2022-02-01 phoqueu → phq-u
    [phq-u.kicad_pcb, phq-u.kicad_sch]
2022-02-01 Add enclosure connection strip
    [phq-u.kicad_pcb]
2022-02-01 Add thermal vias and clean up silkscreen
    [phq-u.kicad_pcb]
2022-02-01 Copy earth strips to back
    [phq-u.kicad_pcb]
2022-02-01 Add annotations to silkscreen
    [phq-u.kicad_pcb]
2022-02-02 Invert project URL QR code
    [phq-u.kicad_pcb]
2022-02-02 Exclude ancillary I/O header from BOM
    [control.kicad_sch, phq-u.kicad_pcb]
2022-02-02 Exclude optional ground bias resistor from BOM
    [phq-u.kicad_pcb, phq-u.kicad_sch]
2022-02-02 Position mounting holes closer to corners
    A distance of 7.5 mm to the edges should provide sufficient mechanical
    stability.
    [phq-u.kicad_pcb]
2022-02-02 Add 3.3 V TVS diodes and revise ground zones
    [control.kicad_sch, icap.kicad_sch, ocap.kicad_sch, phq-u.kicad_pcb, phq-u.kicad_sch]
2022-02-02 Correct clearance violations
    [phq-u.kicad_pcb]
2022-02-02 Re‐route ground traces
    [phq-u.kicad_pcb]
2022-02-02 Clean up schematic
    [control.kicad_sch, icap.kicad_sch, ocap.kicad_sch, phq-u.kicad_pcb, phq-u.kicad_sch]
2022-02-02 Correct ESP32-C3 pad connection
    [phq-u.kicad_pcb]
2022-02-02 Re‐arrange silkscreen items
    [phq-u.kicad_pcb]
2022-02-02 Properly centre 3V3 traces
    [phq-u.kicad_pcb]
2022-02-02 Connect TC2030 ground pad through via
    [phq-u.kicad_pcb]
2022-02-02 Add and adjust vias
    [phq-u.kicad_pcb]
2022-02-04 Replace generic I/O with LED connector
    [control.kicad_sch, icap.kicad_sch, ocap.kicad_sch, phq-u.kicad_pcb, phq-u.kicad_sch]
2022-02-13 Replace resistors with available variants
    [control.kicad_sch, phq-u.kicad_pcb, phq-u.kicad_sch]
2022-02-13 Add revision number to silkscreen
    [phq-u.kicad_pcb]
2022-02-26 Add separate ADCs for remote measurements
    [control.kicad_sch, icap.kicad_sch, ocap.kicad_sch, phq-u.kicad_pcb, phq-u.kicad_sch]
